UdithWeerasinghe/EDR/README.md

# EDR
This is about the individual project "Water Quality Monitoring System" I am doing for Engineering Design Realization.
