UdithWeerasinghe/EDR/SW_200702H.pdf

Department of Electronic and Telecommunication Engineering

University Of Moratuwa


Solidwork design resubmission

Index No. | Name
200702H | P.D.G.U.M.B. WEERASINGHE

This assignment is submitted as a partial fulfillment of the module EN2160 – Electronic Design & Realization

Sketches

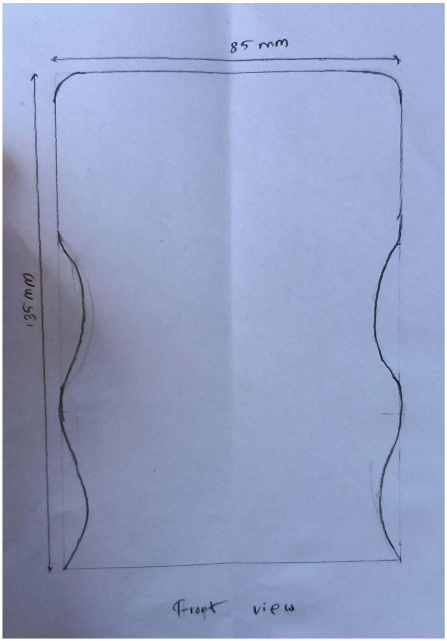
[picture p28: figure]

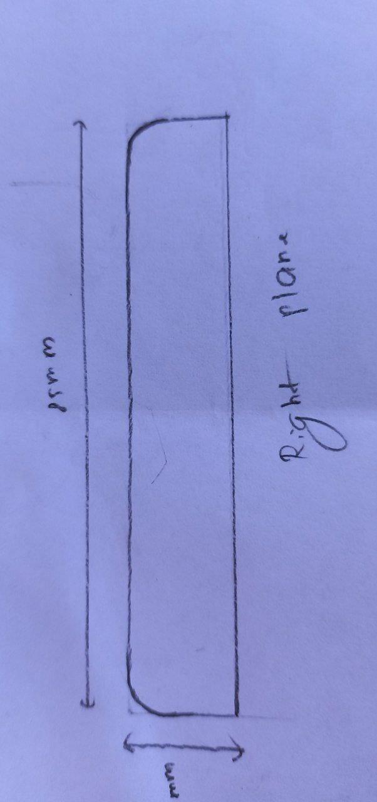
[picture p29: figure]

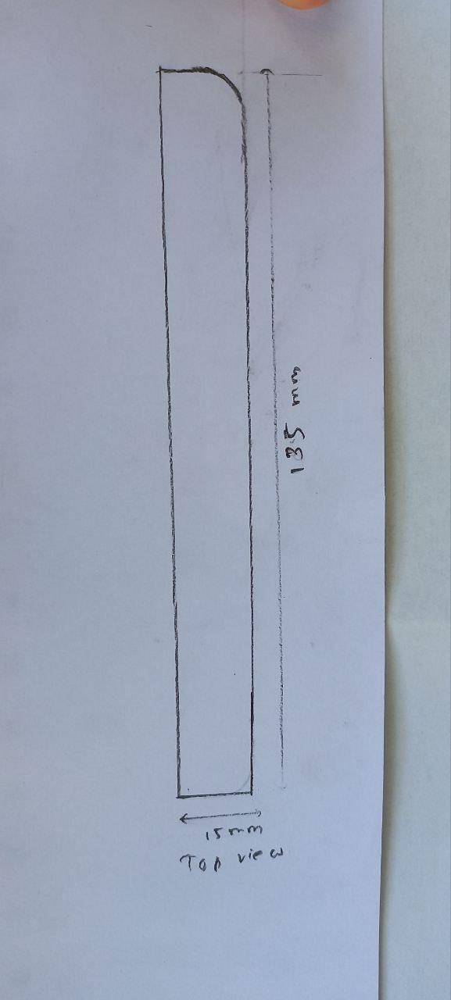
[picture p30: figure]

Design

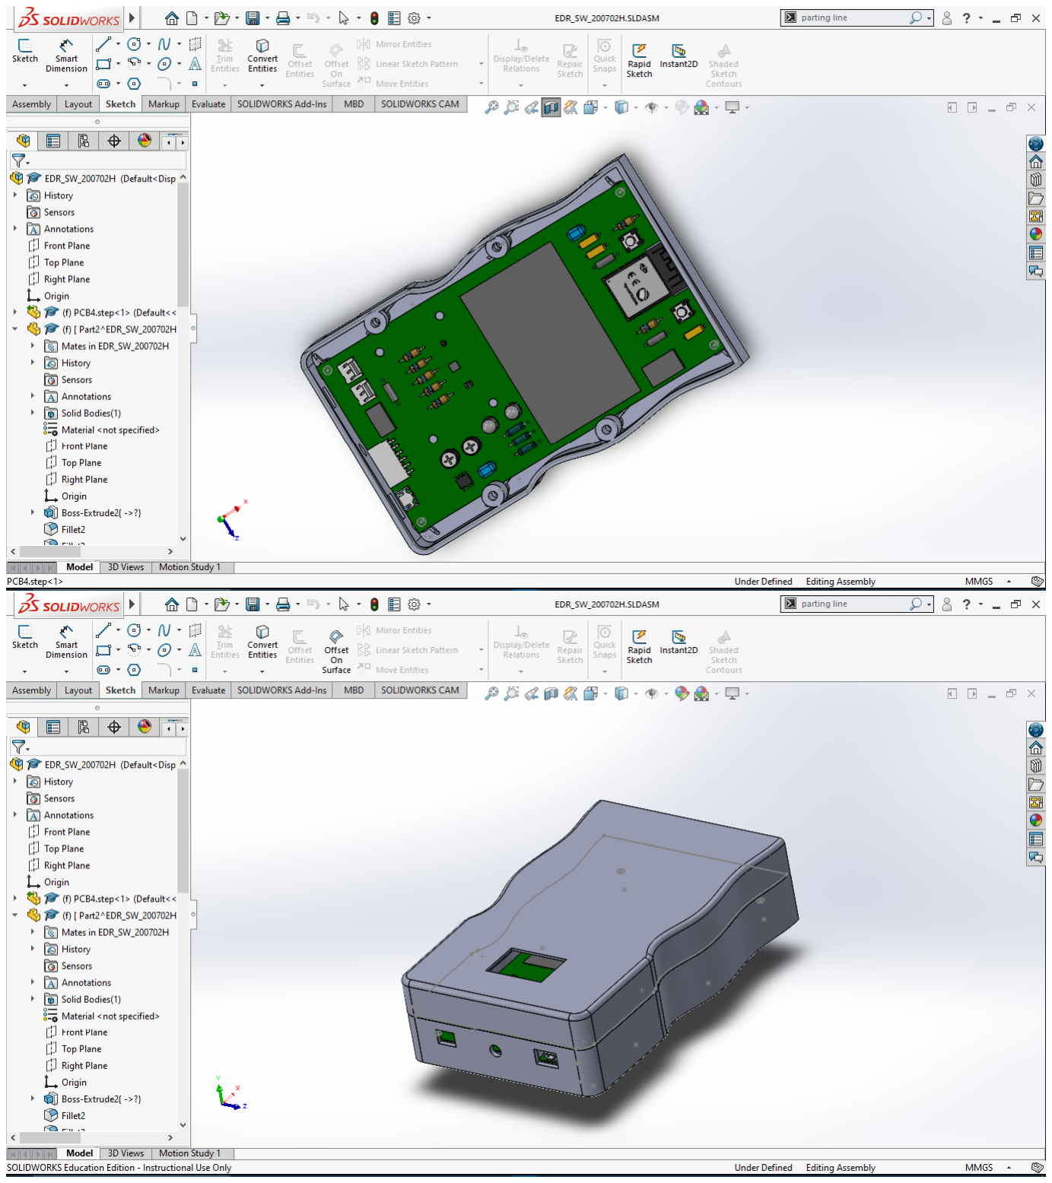
[picture p31: figure]

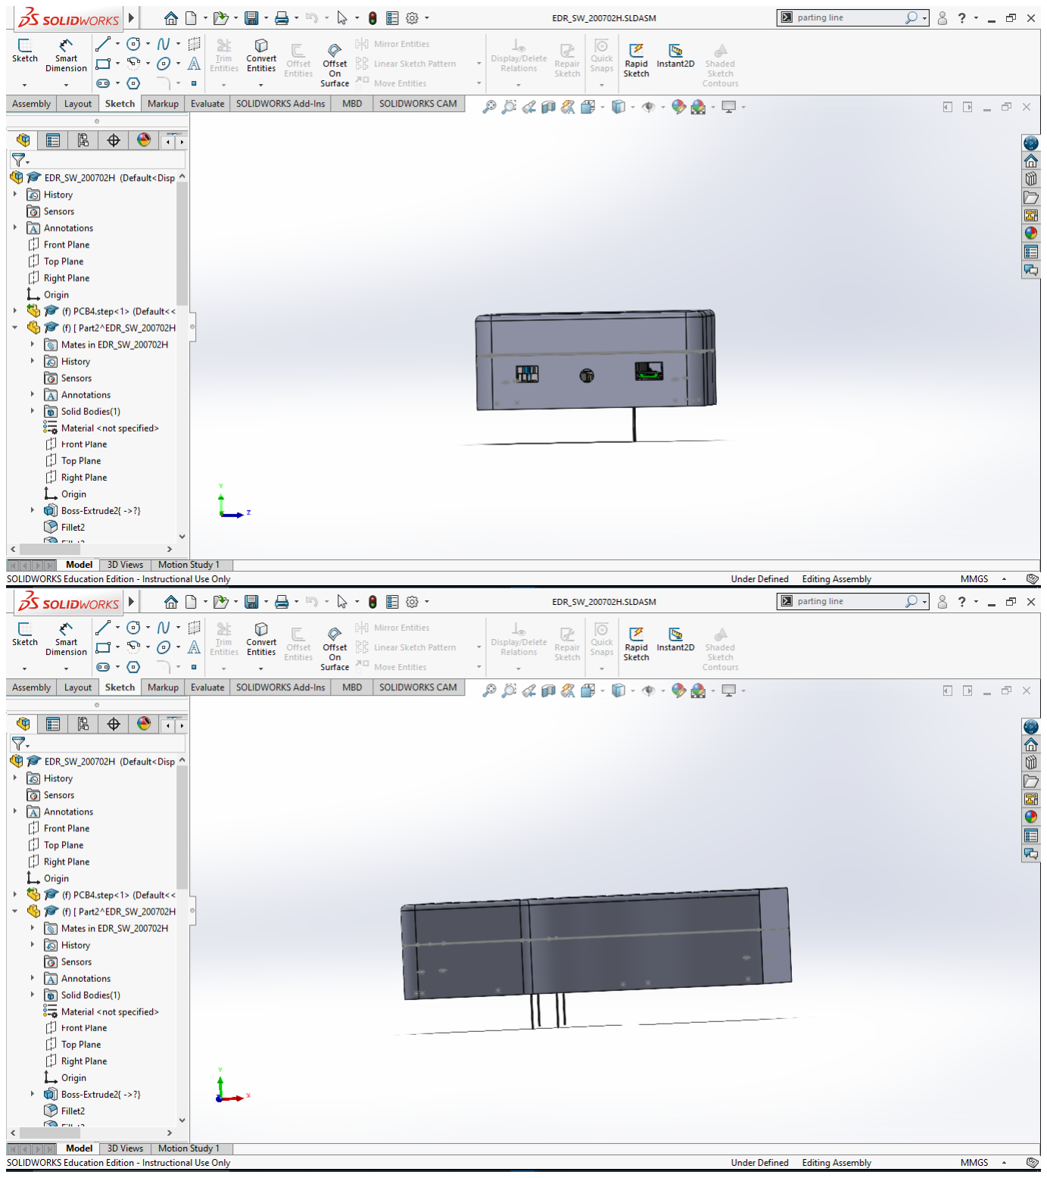
[picture p32: figure]

Draft Analysis

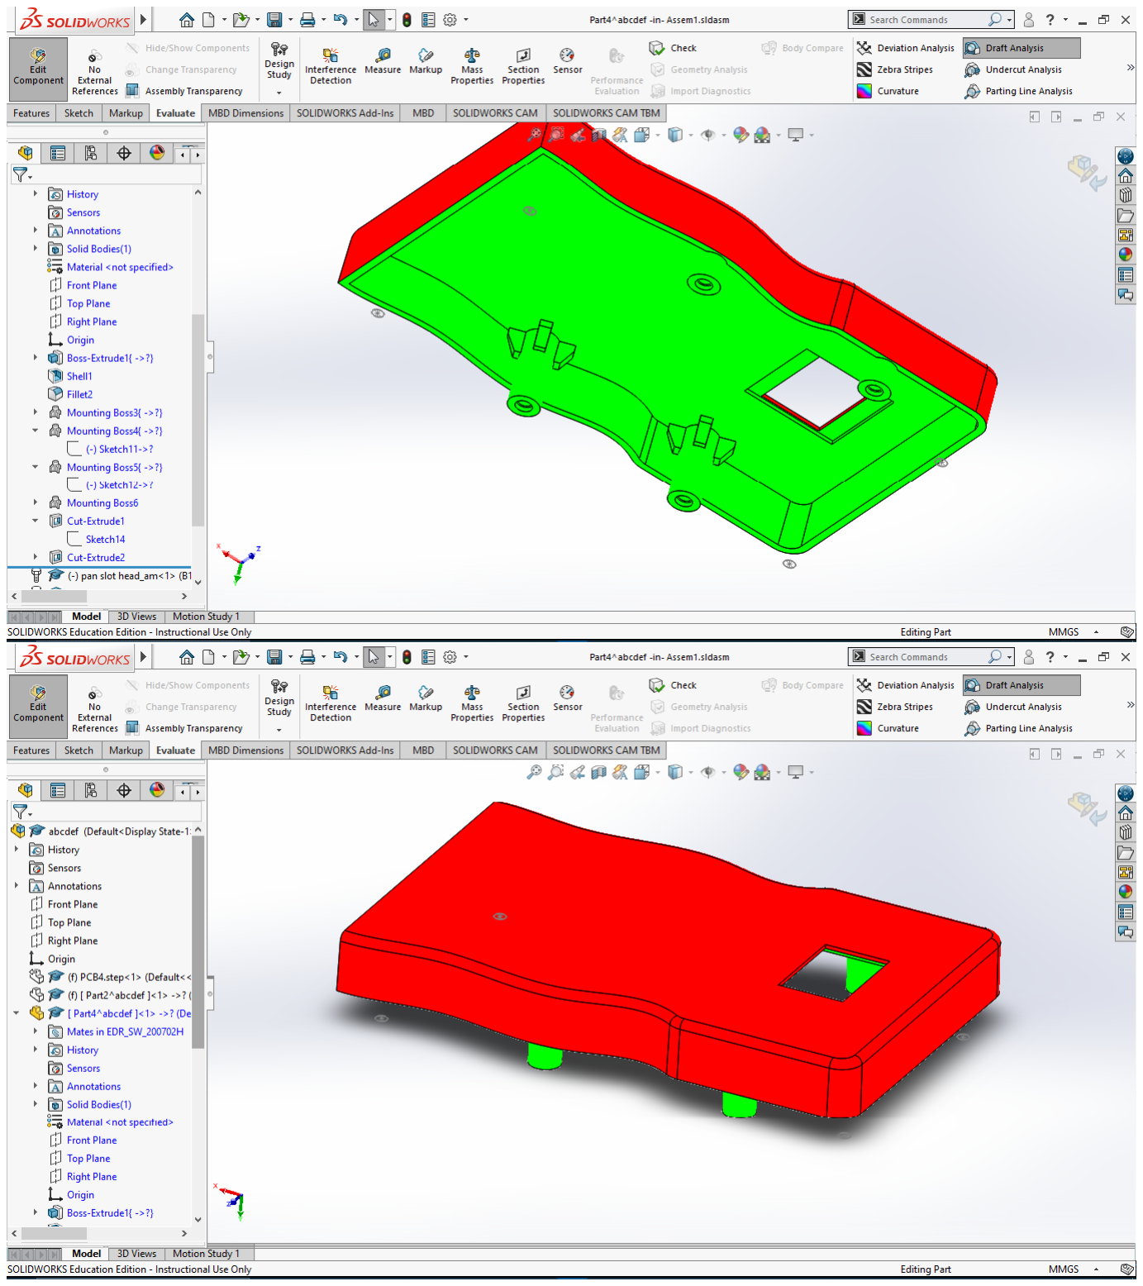
[picture p33: figure]

Mold design

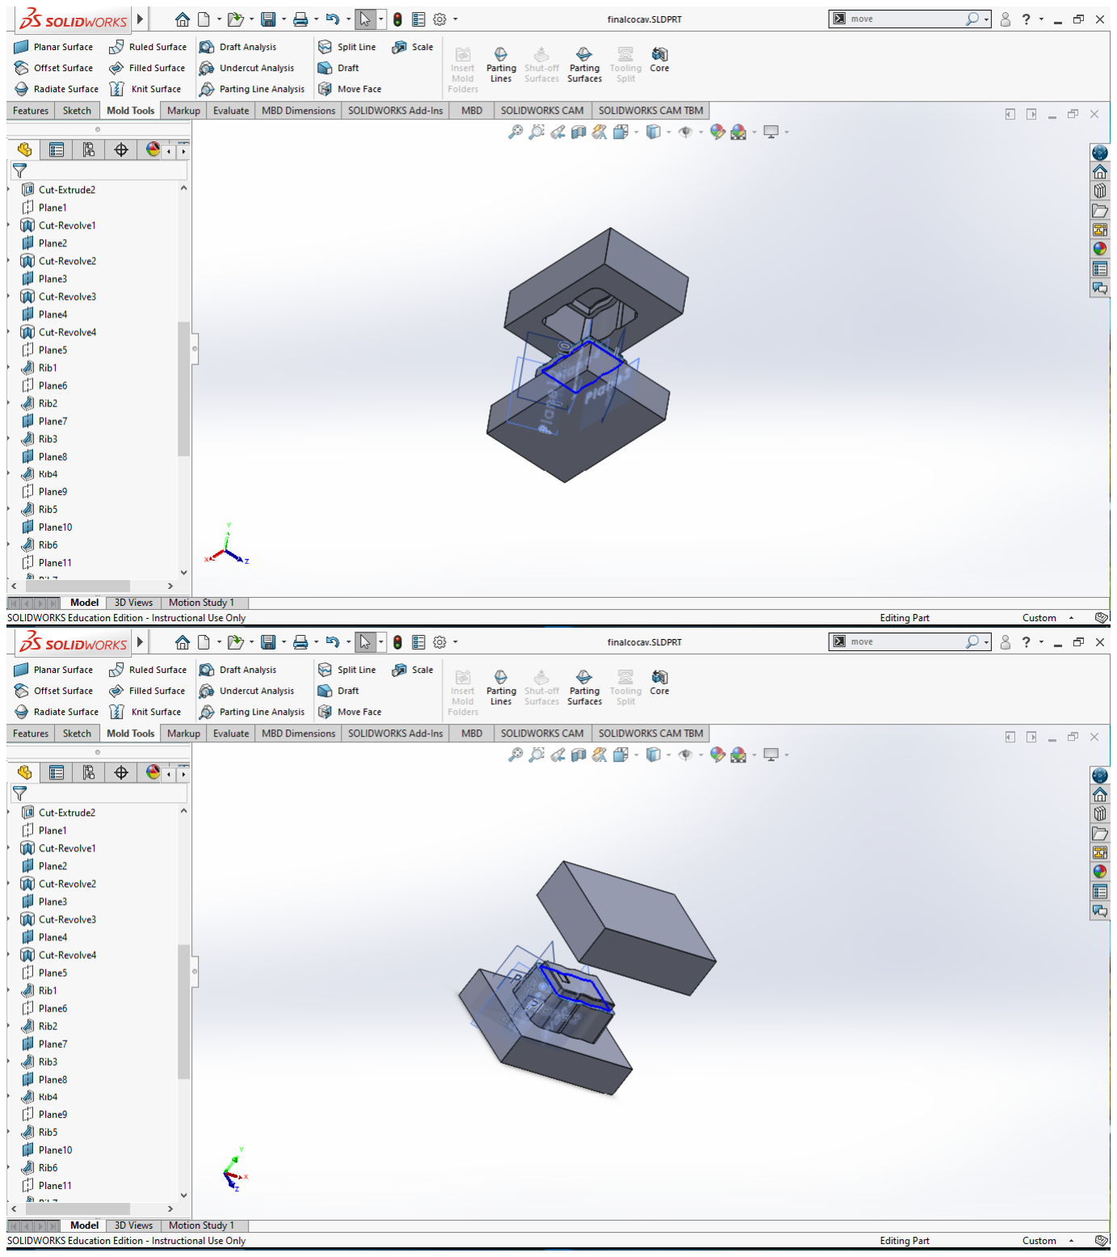
[picture p34: figure]
