UdithWeerasinghe/EDR/200702H_EDR/assemblyfinal.SLDASM

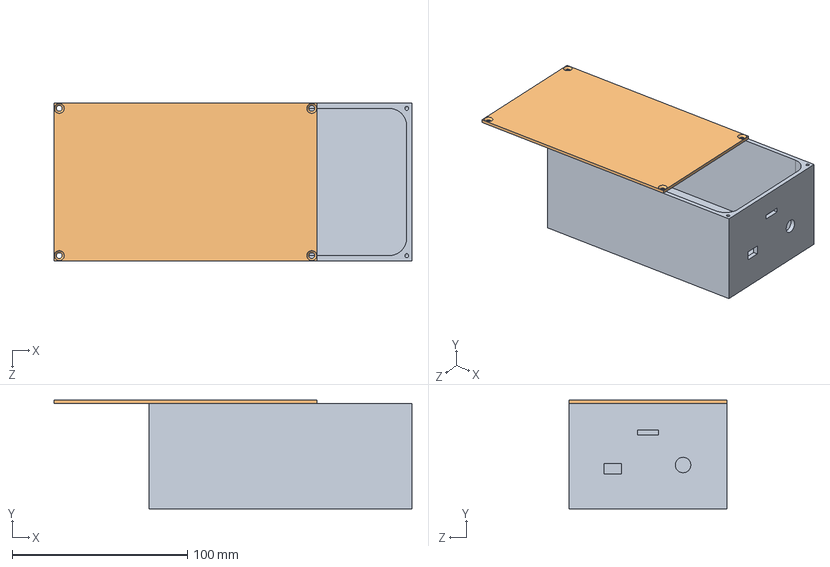
[picture p35: CAD file, 2023-09-12]
200702H_EDR/assemblyfinal.SLDASM
204.2 x 62.0 x 90.0 mm
wqmboxwithholes
wqmlid
