UdithWeerasinghe/EDR/(list of files, drawings)

Other design files:
200702H_EDR/PCB2.PcbDoc
200702H_EDR/Sheet1.SchDoc
